12354fdw/goofy-wica/boards/field_device/field_device.kicad_pcb

## KiCad design boards/field_device/field_device.kicad_pcb (2026-10-09)

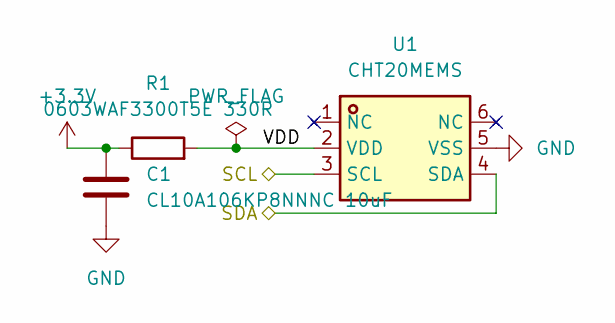
[picture p1: schematic humidity_sensor.kicad_sch, Field Device Humidity Sensor]

Parts:
C1: CL10A106KP8NNNC 10uF; C_0603_1608Metric_Pad1.08x0.95mm_HandSolder
R1: 0603WAF3300T5E 330R; C_0603_1608Metric
U1: CHT20MEMS; LGA-6_L3.0-W3.0-P1.00-BR; MPN CHT20MEMS; LCSC Part C26159166

Connections:
+3.3V: C1.1, R1.1; also elsewhere on the board
/MCU/SCL_bus: U1.3 (SCL); also elsewhere on the board
/MCU/SDA_bus: U1.4 (SDA); also elsewhere on the board
/humidity_sensor/VDD: R1.2, U1.2 (VDD)
GND: C1.2, U1.5 (VSS); also elsewhere on the board

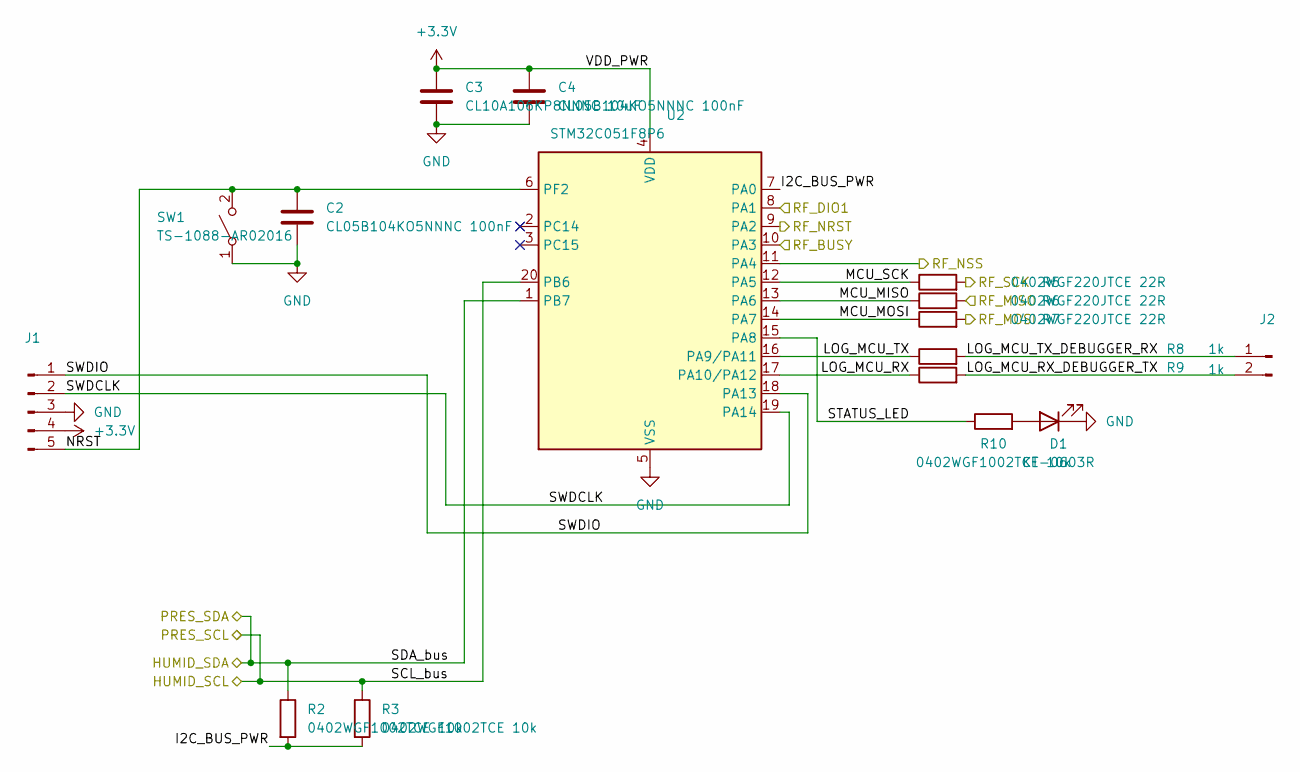
[picture p2: schematic mcu.kicad_sch, Field Device MCU]

Parts:
C2, C4: CL05B104KO5NNNC 100nF; C_0402_1005Metric_Pad0.74x0.62mm_HandSolder
C3: CL10A106KP8NNNC 10uF; C_0603_1608Metric_Pad1.08x0.95mm_HandSolder
D1: KT-0603R; LED_0603_1608Metric_Pad1.05x0.95mm_HandSolder
J1: PinHeader_1x05_P2.54mm_Vertical
J2: PinHeader_1x02_P2.54mm_Vertical
R2, R3, R10: 0402WGF1002TCE 10k; R_0402_1005Metric_Pad0.72x0.64mm_HandSolder
R5, R6, R7: 0402WGF220JTCE 22R; R_0402_1005Metric_Pad0.72x0.64mm_HandSolder
R8, R9: 1k; R_0402_1005Metric_Pad0.72x0.64mm_HandSolder
SW1: TS-1088-AR02016; SW-SMD_L3.9-W3.0-P4.45
U2: STM32C051F8P6; TSSOP-20_4.4x6.5mm_P0.65mm

Connections:
+3.3V: C3.1, C4.1, J1.4, U2.4 (VDD); also elsewhere on the board
/MCU/I2C_BUS_PWR: R2.2, R3.2, U2.7 (PA0)
/MCU/LOG_MCU_RX: R9.1, U2.17 (PA10/PA12)
/MCU/LOG_MCU_RX_DEBUGGER_TX: J2.2, R9.2
/MCU/LOG_MCU_TX: R8.1, U2.16 (PA9/PA11)
/MCU/LOG_MCU_TX_DEBUGGER_RX: J2.1, R8.2
/MCU/MCU_MISO: R6.1, U2.13 (PA6)
/MCU/MCU_MOSI: R7.1, U2.14 (PA7)
/MCU/MCU_SCK: R5.1, U2.12 (PA5)
/MCU/NRST: C2.1, J1.5, SW1.2 (B), U2.6 (PF2)
/MCU/RF_BUSY: U2.10 (PA3); also elsewhere on the board
/MCU/RF_DIO1: U2.8 (PA1); also elsewhere on the board
/MCU/RF_MISO: R6.2; also elsewhere on the board
/MCU/RF_MOSI: R7.2; also elsewhere on the board
/MCU/RF_NRST: U2.9 (PA2); also elsewhere on the board
/MCU/RF_NSS: U2.11 (PA4); also elsewhere on the board
/MCU/RF_SCK: R5.2; also elsewhere on the board
/MCU/SCL_bus: R3.1, U2.20 (PB6); also elsewhere on the board
/MCU/SDA_bus: R2.1, U2.1 (PB7); also elsewhere on the board
/MCU/STATUS_LED: R10.1, U2.15 (PA8)
/MCU/SWDCLK: J1.2, U2.19 (PA14)
/MCU/SWDIO: J1.1, U2.18 (PA13)
GND: C2.2, C3.2, C4.2, D1.1 (K), J1.3, SW1.1 (A), U2.5 (VSS); also elsewhere on the board
unnamed: D1.2 (A), R10.2

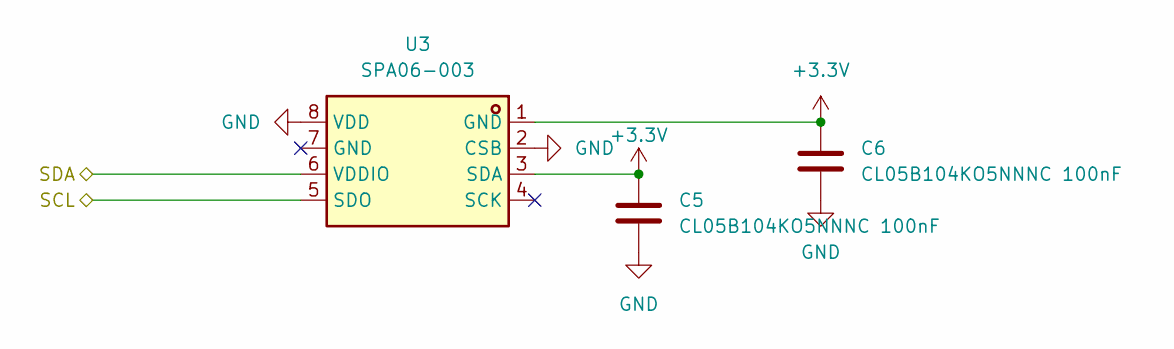
[picture p3: schematic pressure_sensor.kicad_sch, Field Device Pressure Sensor]

Parts:
C5, C6: CL05B104KO5NNNC 100nF; C_0402_1005Metric_Pad0.74x0.62mm_HandSolder
U3: SPA06-003; LGA-8_L2.5-W2.0-P0.65_SPA06-003; MPN SPA06-003; LCSC Part C30589048

Connections:
+3.3V: C5.1, C6.1, U3.1 (GND), U3.3 (SDA); also elsewhere on the board
/MCU/SCL_bus: U3.5 (SDO); also elsewhere on the board
/MCU/SDA_bus: U3.6 (VDDIO); also elsewhere on the board
GND: C5.2, C6.2, U3.2 (CSB), U3.8 (VDD); also elsewhere on the board

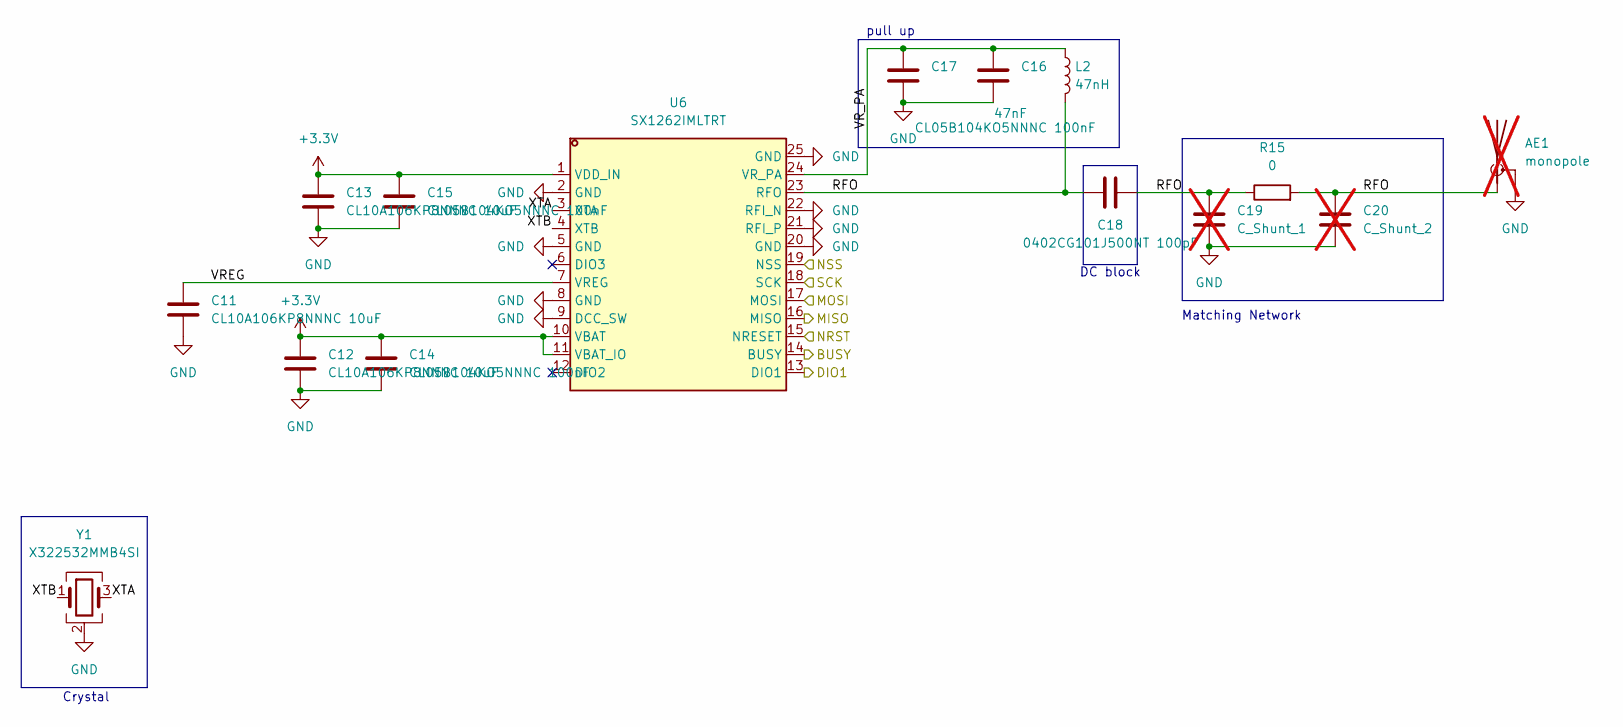
[picture p4: schematic lora_module.kicad_sch, Field Device RF communications]

Parts:
AE1: monopole; TI DN023 868-955MHz Antenna; not fitted
C11, C12, C13: CL10A106KP8NNNC 10uF; C_0603_1608Metric_Pad1.08x0.95mm_HandSolder
C14, C15: CL05B104KO5NNNC 100nF; C_0402_1005Metric_Pad0.74x0.62mm_HandSolder
C16: 47nF; C_0603_1608Metric
C17: CL05B104KO5NNNC 100nF; C_0402_1005Metric
C18: 0402CG101J500NT 100pF; C_0402_1005Metric_Pad0.74x0.62mm_HandSolder
C19: C_Shunt_1; C_0402_1005Metric_Pad0.74x0.62mm_HandSolder; not fitted
C20: C_Shunt_2; C_0402_1005Metric_Pad0.74x0.62mm_HandSolder; not fitted
L2: 47nH; L_0805_2012Metric_Pad1.05x1.20mm_HandSolder
R15: 0; R_0402_1005Metric_Pad0.72x0.64mm_HandSolder
U6: SX1262IMLTRT; QFN-24_L4.0-W4.0-P0.50-BL-EP2.6; MPN SX1262IMLTRT; LCSC Part C191341
Y1: X322532MMB4SI; CRYSTAL-SMD_4P-L3.2-W2.5-BL

Connections:
+3.3V: C12.1, C13.1, C14.1, C15.1, U6.1 (VDD_IN), U6.10 (VBAT), U6.11 (VBAT_IO); also elsewhere on the board
/MCU/RF_BUSY: U6.14 (BUSY); also elsewhere on the board
/MCU/RF_DIO1: U6.13 (DIO1); also elsewhere on the board
/MCU/RF_MISO: U6.16 (MISO); also elsewhere on the board
/MCU/RF_MOSI: U6.17 (MOSI); also elsewhere on the board
/MCU/RF_NRST: U6.15 (NRESET); also elsewhere on the board
/MCU/RF_NSS: U6.19 (NSS); also elsewhere on the board
/MCU/RF_SCK: U6.18 (SCK); also elsewhere on the board
/lora_module/RFO: AE1.1 (A), C18.1, C18.2, C19.1, C20.1, L2.2, R15.1, R15.2, U6.23 (RFO)
/lora_module/VREG: C11.1, U6.7 (VREG)
/lora_module/VR_PA: C16.1, C17.1, L2.1, U6.24 (VR_PA)
/lora_module/XTA: U6.3 (XTA), Y1.3
/lora_module/XTB: U6.4 (XTB), Y1.1
GND: AE1.2 (Shield), C11.2, C12.2, C13.2, C14.2, C15.2, C16.2, C17.2, C19.2, C20.2, U6.2 (GND), U6.5 (GND), U6.8 (GND), U6.9 (DCC_SW), U6.20 (GND), U6.21 (RFI_P), U6.22 (RFI_N), U6.25 (GND), Y1.2 (G), Y1.4 (G); also elsewhere on the board

Notes on the sheet:
pull up
DC block
Matching Network
Crystal

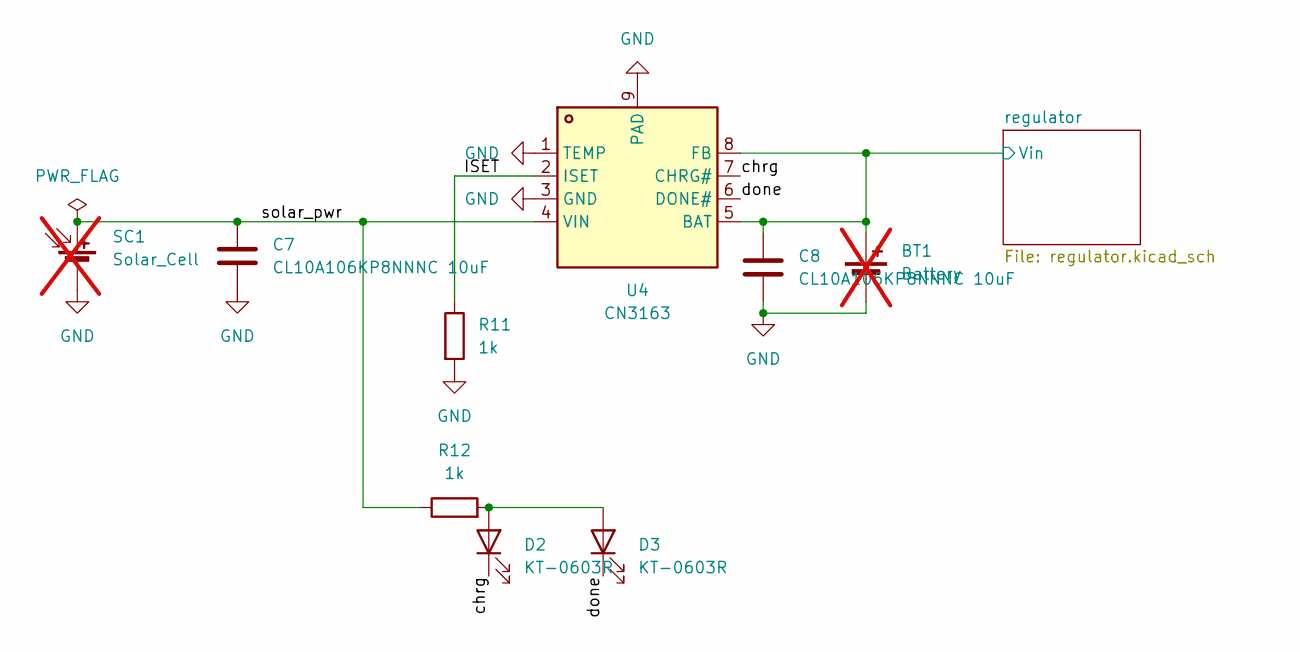
[picture p5: schematic power_source.kicad_sch, Field Device Power Supply]

Parts:
BT1: Battery; battery_2_smd; not fitted
C7, C8: CL10A106KP8NNNC 10uF; C_0603_1608Metric_Pad1.08x0.95mm_HandSolder
D2, D3: KT-0603R; LED_0603_1608Metric_Pad1.05x0.95mm_HandSolder
R11, R12: 1k; R_0402_1005Metric_Pad0.72x0.64mm_HandSolder
SC1: Solar_Cell; battery_2_smd; not fitted
U4: CN3163; ESOP-8_L4.9-W3.9-P1.27-LS6.0-BL-EP; MPN CN3163; LCSC Part C559031

Connections:
/power_source/ISET: R11.1, U4.2 (ISET)
/power_source/chrg: D2.1 (K), U4.7 (CHRG#)
/power_source/done: D3.1 (K), U4.6 (DONE#)
/power_source/regulator/Vin: BT1.1 (+), C8.1, U4.5 (BAT), U4.8 (FB); also elsewhere on the board
/power_source/solar_pwr: C7.1, R12.1, SC1.1 (+), U4.4 (VIN)
GND: BT1.2 (-), C7.2, C8.2, R11.2, SC1.2 (-), U4.1 (TEMP), U4.3 (GND), U4.9 (PAD); also elsewhere on the board
unnamed: D2.2 (A), D3.2 (A), R12.2

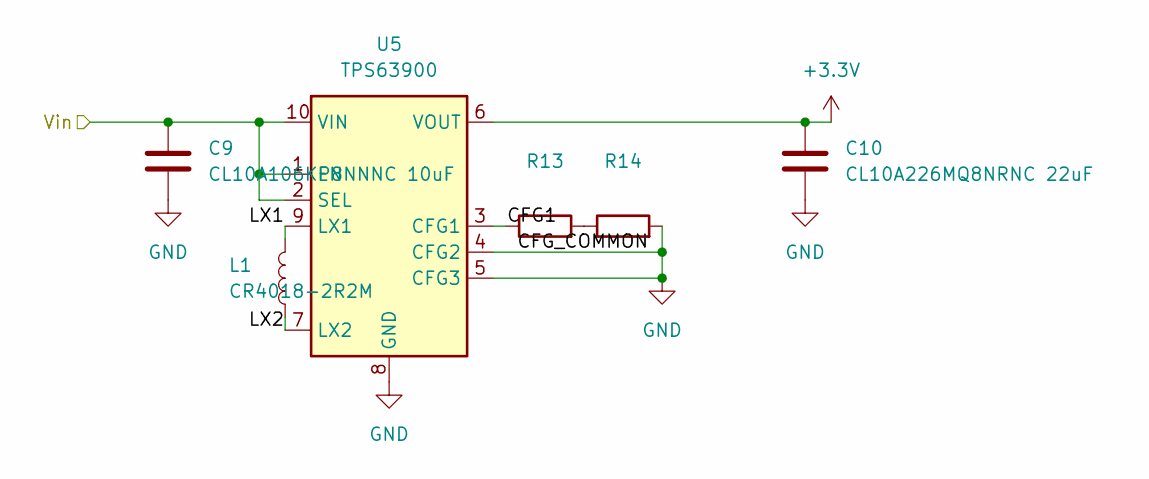
[picture p6: schematic regulator.kicad_sch, Field Device Regulator]

Parts:
C9: CL10A106KP8NNNC 10uF; C_0603_1608Metric_Pad1.08x0.95mm_HandSolder
C10: CL10A226MQ8NRNC 22uF; C_0603_1608Metric_Pad1.08x0.95mm_HandSolder
L1: CR4018-2R2M; IND-SMD_L4.0-W4.0
R13: 0603WAF3601T5E; R_0603_1608Metric
R14: 0603WAF3302T5E; R_0603_1608Metric
U5: TPS63900; WSON-10-1EP_2.5x2.5mm_P0.5mm_EP1.2x2mm_ThermalVias

Connections:
+3.3V: C10.1, U5.6 (VOUT); also elsewhere on the board
/power_source/regulator/CFG1: R13.1, U5.3 (CFG1)
/power_source/regulator/LX1: L1.2, U5.9 (LX1)
/power_source/regulator/LX2: L1.1, U5.7 (LX2)
/power_source/regulator/Vin: C9.1, U5.1 (EN), U5.2 (SEL), U5.10 (VIN); also elsewhere on the board
GND: C9.2, C10.2, R14.2, U5.4 (CFG2), U5.5 (CFG3), U5.8 (GND), U5.11 (GND); also elsewhere on the board
unnamed: R13.2, R14.1

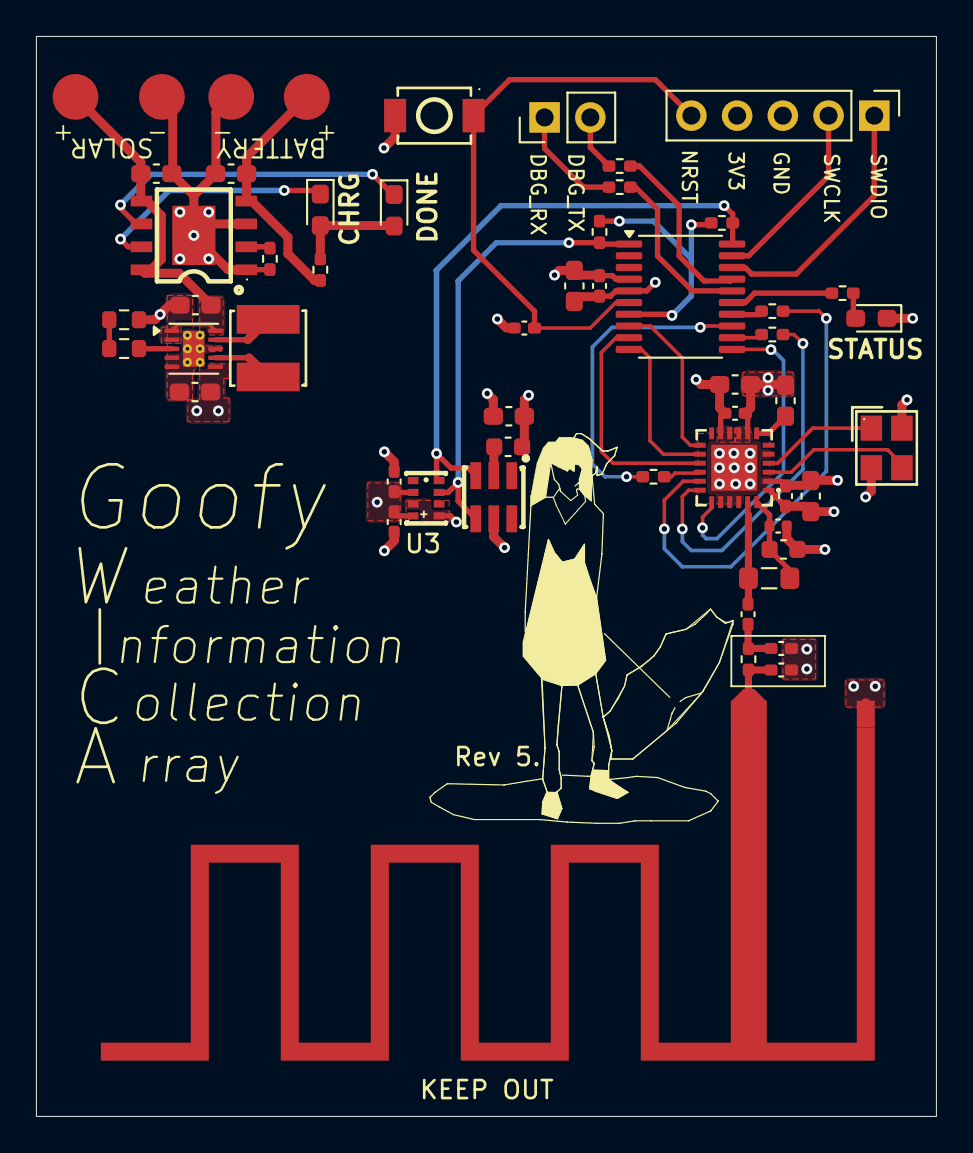
[picture p7: board field_device.kicad_pcb from above]

Board: 4 copper layers, 50.0 x 60.0 mm, 52 parts (0 on the bottom side), 40 nets.
