12354fdw/goofy-wica/sources/field_device/Src/init.c

#include "init.h"
#include "Driver/rf.h"
#include "Driver/spi.h"
#include "Driver/i2c.h"
#include "hal.h"
#include "stm32c051xx.h"

#include <stdint.h>
#include <stdio.h>

#define UART_BAUD 115200u
#define HSI16_HZ 48000000u

void init(void) {
	// port remap
	HAL_Peripheral_EnableClock(HAL_PERIPH_SYSCFG);
	SYSCFG->CFGR1 |= SYSCFG_CFGR1_PA11_RMP | SYSCFG_CFGR1_PA12_RMP;

	// init ports
	HAL_GPIO_EnableClock(GPIOA);
	HAL_GPIO_EnableClock(GPIOB);

	// init logging
	HAL_Peripheral_EnableClock(HAL_PERIPH_USART1);

	// set PA9 to AF1 (USART1_TX)
	HAL_GPIO_Init(GPIOA, 9, GPIO_MODE_AF, GPIO_PULL_UP);
	HAL_GPIO_AF_Init(GPIOA, 9, 1);

	// set PA10 to AF1 (USART1_RX)
	HAL_GPIO_Init(GPIOA, 10, GPIO_MODE_AF, GPIO_PULL_UP);
	HAL_GPIO_AF_Init(GPIOA, 10, 1);

	USART1->BRR = HSI16_HZ / UART_BAUD;
	USART1->CR1 |= USART_CR1_TE | USART_CR1_RE | USART_CR1_UE;

	printf("hello\r\n");

	// actual init

	printf("init peripherals...");

	// SPI1 for RF
	HAL_Peripheral_EnableClock(HAL_PERIPH_SPI1);
	SYS_SPI_Init();

	// I2C1 for I2C bus
	HAL_Peripheral_EnableClock(HAL_PERIPH_I2C1);
	SYS_I2C_Init();

	printf("ok\r\n");

	printf("init pins...");

	SYS_RF_InitPins();

	// I2C bus
	// SCL
	HAL_GPIO_Init(GPIOB, 6, GPIO_MODE_AF, GPIO_PULL_UP);
	HAL_GPIO_AF_Init(GPIOB, 6, 6);

	// SDA
	HAL_GPIO_Init(GPIOB, 7, GPIO_MODE_AF, GPIO_PULL_UP);
	HAL_GPIO_AF_Init(GPIOB, 7, 6);

	printf("ok\r\n");
}

int _write(int file, char *ptr, int len) {
	(void)file;
	for (int i = 0; i < len; i++) {
		while (!(USART1->ISR & USART_ISR_TXE_TXFNF))
			;
		USART1->TDR = ptr[i];
	}
	return len;
}
