12354fdw/goofy-wica/(commit log)

2026-09-22 removed 0 ohms resistors
    [field_device.kicad_pcb, mcu.kicad_sch, power_source.kicad_sch, pressure_sensor.kicad_sch, regulator.kicad_sch]
2026-09-22 added decoupling capacitors on SDA and SCL
    [mcu.kicad_sch]
2026-09-22 RF fun is soon!
    [field_device.kicad_sch, lora_module.kicad_sch]
2026-09-23 RF is fun!
    [lora_module.kicad_sch]
2026-09-23 connected crystal
    [humidity_sensor.kicad_sch, lora_module.kicad_sch]
2026-09-23 made ERC happy
    [humidity_sensor.kicad_sch, lora_module.kicad_sch, mcu.kicad_sch, power_source.kicad_sch, pressure_sensor.kicad_sch, regulator.kicad_sch]
2026-09-24 connected lora to mcu
    [field_device.kicad_sch, lora_module.kicad_sch, mcu.kicad_sch]
2026-09-25 forgo the power planes
    [field_device.kicad_pcb]
2026-09-25 added sources + some pcb routing
    [field_device.kicad_pcb]
2026-09-25 added STM32C0xx headers
2026-09-25 actual shit in a kettle (added uart pins)
    WRITING REGISTERS IS PAIN!!!!!!!!!
    [mcu.kicad_sch]
2026-09-25 fix: forgo port remap
    [hal.c, hal.h, init.c]
2026-09-25 reorganized mcu
    [humidity_sensor.kicad_sch, lora_module.kicad_sch, mcu.kicad_sch, power_source.kicad_sch, pressure_sensor.kicad_sch, regulator.kicad_sch]
2026-09-25 reorganized regulator
    [mcu.kicad_sch, power_source.kicad_sch, regulator.kicad_sch]
2026-09-25 added satus leds
    [humidity_sensor.kicad_sch, lora_module.kicad_sch, mcu.kicad_sch, power_source.kicad_sch, pressure_sensor.kicad_sch, regulator.kicad_sch]
2026-09-25 feat: init I2C bus
2026-09-26 i guess made schematic more readable?
    [field_device.kicad_pcb, mcu.kicad_sch, power_source.kicad_sch, pressure_sensor.kicad_sch]
2026-09-26 assigned better footprints
    [field_device.kicad_pcb, humidity_sensor.kicad_sch, lora_module.kicad_sch, mcu.kicad_sch, power_source.kicad_sch, regulator.kicad_sch]
2026-09-27 changed regulator
    [field_device.kicad_pcb, humidity_sensor.kicad_sch, lora_module.kicad_sch, mcu.kicad_sch, power_source.kicad_sch, pressure_sensor.kicad_sch, regulator.kicad_sch]
2026-09-27 added inductor footprint and did regulator routing
    [field_device.kicad_pcb, regulator.kicad_sch]
2026-09-27 route regulator
    [field_device.kicad_pcb, power_source.kicad_sch]
2026-09-27 route more stuff
    [field_device.kicad_pcb, humidity_sensor.kicad_sch, power_source.kicad_sch, pressure_sensor.kicad_sch]
2026-09-27 routed everything
    [field_device.kicad_pcb, mcu.kicad_sch]
2026-10-01 moved modules to make space for antenna
    [field_device.kicad_pcb, lora_module.kicad_sch]
2026-10-01 move resistors closer to pins
    [field_device.kicad_pcb]
2026-10-07 refined schematic
    [field_device.kicad_pcb, lora_module.kicad_sch, power_source.kicad_sch, pressure_sensor.kicad_sch, regulator.kicad_sch]
2026-10-08 rrev 4
    [bom.csv, designators.csv, field_device.csv, field_device.kicad_pcb, field_device.kicad_sch, humidity_sensor.kicad_sch, lora_module.kicad_sch, mcu.kicad_sch]
2026-10-08 i dont even know
    [field_device.kicad_pcb, regulator.kicad_sch]
2026-10-08 what is even happening
    [field_device.kicad_sch, humidity_sensor.kicad_sch, lora_module.kicad_sch, mcu.kicad_sch, power_source.kicad_sch, pressure_sensor.kicad_sch, regulator.kicad_sch]
2026-10-08 rev 5?
    [field_device.kicad_pcb, field_device.kicad_sch, humidity_sensor.kicad_sch, lora_module.kicad_sch, mcu.kicad_sch, power_source.kicad_sch, pressure_sensor.kicad_sch, regulator.kicad_sch]
2026-10-09 peer review
    [field_device.kicad_pcb]
2026-10-09 add serial number and change silk screen
    [bom.csv, designators.csv, field_device.kicad_pcb, positions.csv]
2026-10-09 move serial number
    [field_device.kicad_pcb]
2026-10-09 change components to fit manufacturing capability
    [bom.csv, field_device.kicad_pcb, field_device.kicad_sch, humidity_sensor.kicad_sch, lora_module.kicad_sch, mcu.kicad_sch, positions.csv, power_source.kicad_sch]
2026-10-09 idk atp
    [field_device.kicad_pcb, humidity_sensor.kicad_sch, lora_module.kicad_sch, mcu.kicad_sch, power_source.kicad_sch, pressure_sensor.kicad_sch, regulator.kicad_sch]
